Dimonitr/programmable-stroboscope/README.md

# programmable-stroboscope
System for remote determination of the oscilation frequency using a stroboscopic measurement method
